vaibhav007iitm/Ball-balancing-using-PID-controller/README.md

# Ball-balancing-using-PID-controller
Arduino code with exponential filter for ball balancing on a groove actuated by servo motor.
Simulated model in MatLabSimscafe
