vaibhav007iitm/Ball-balancing-using-PID-controller/7_cad_design_top_view.jpeg

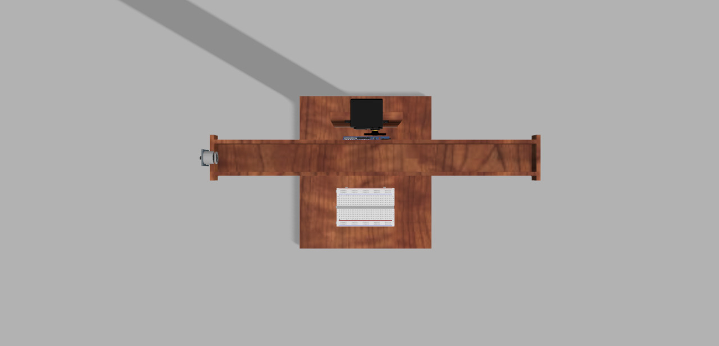
7_cad_design_top_view.jpeg
